sujithkani/ttsky25a-tinyQV/docs/user_peripherals/08_8bit_counter.png

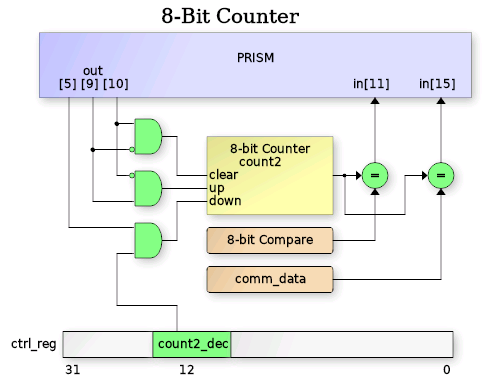
docs/user_peripherals/08_8bit_counter.png
