sujithkani/ttsky25a-tinyQV/docs/user_peripherals/08_comm_register.png

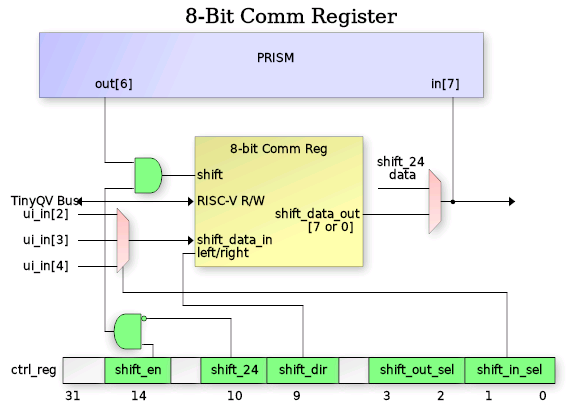
docs/user_peripherals/08_comm_register.png
