sujithkani/ttsky25a-tinyQV/docs/user_peripherals/08_inputs.png

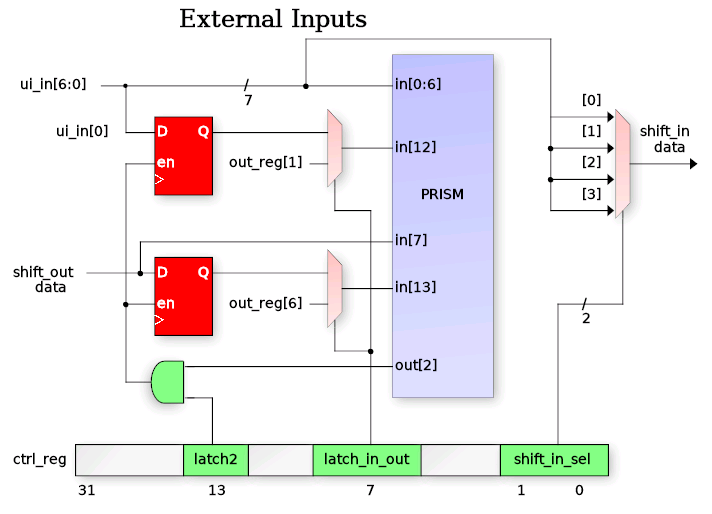
docs/user_peripherals/08_inputs.png
