sujithkani/ttsky25a-tinyQV/docs/user_peripherals/08_outputs.png

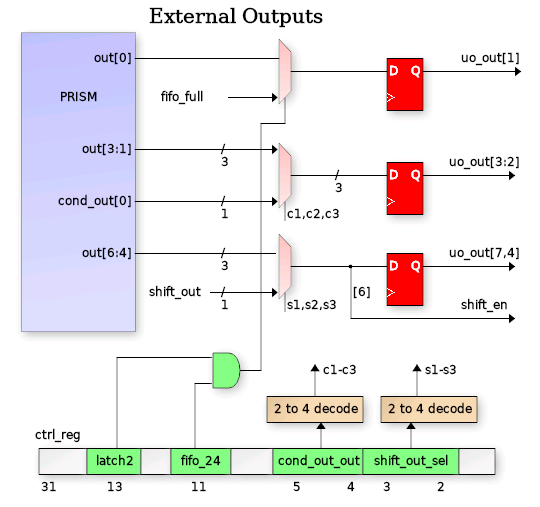
docs/user_peripherals/08_outputs.png
