sujithkani/ttsky25a-tinyQV/docs/user_peripherals/08_prism_periph.png

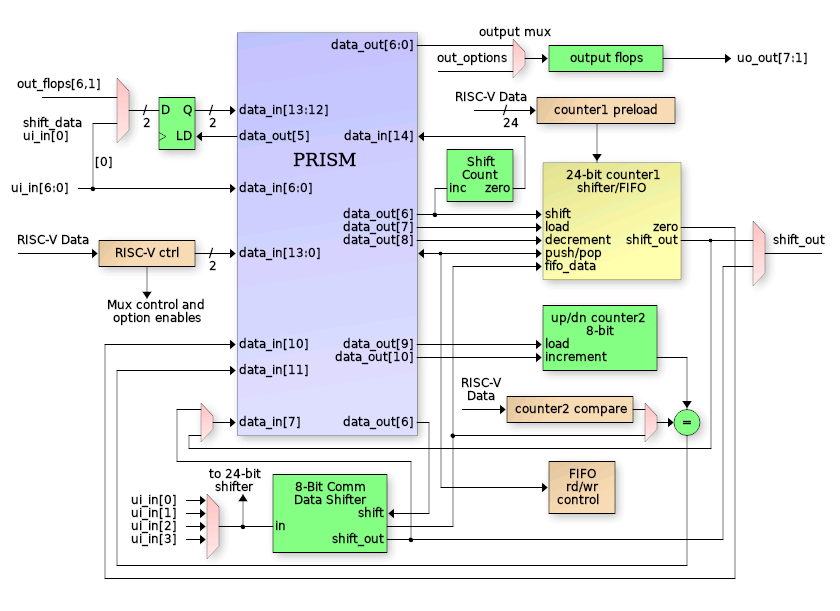
docs/user_peripherals/08_prism_periph.png
