sujithkani/ttsky25a-tinyQV/docs/user_peripherals/10_diagram.png

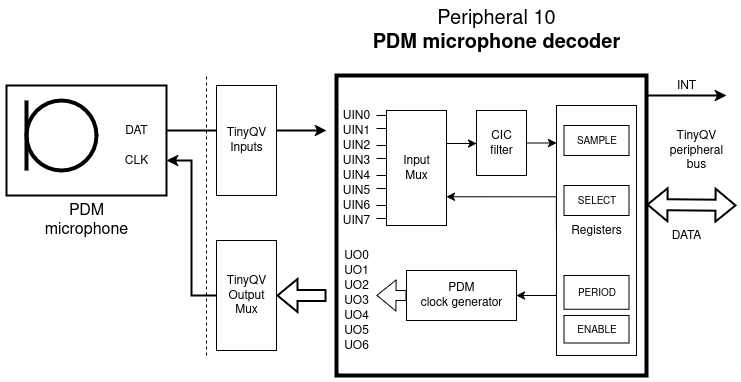
docs/user_peripherals/10_diagram.png
