sujithkani/ttsky25a-tinyQV/docs/user_peripherals/10_spectrogram.png

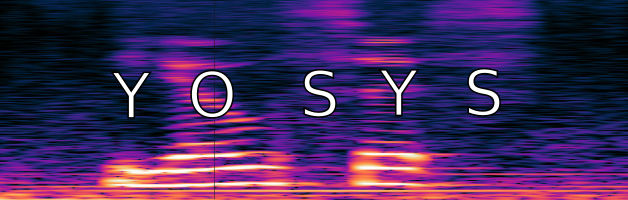
docs/user_peripherals/10_spectrogram.png
