sujithkani/ttsky25a-tinyQV/docs/user_peripherals/11_pulse_transmitter_74HC595.jpg

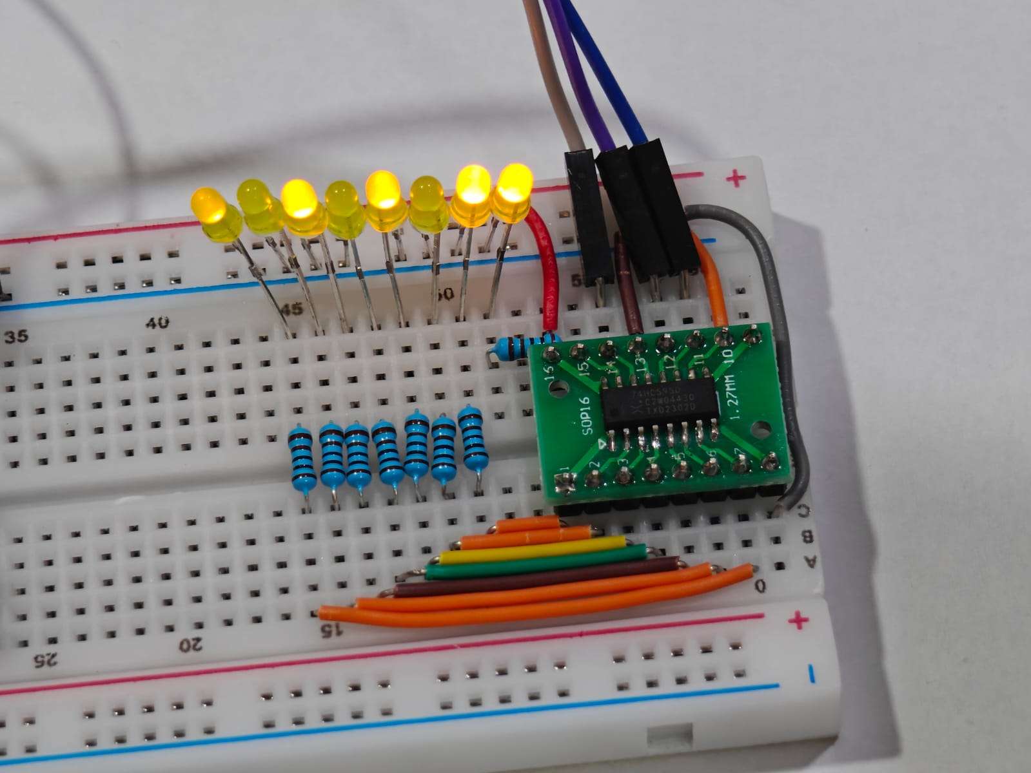
docs/user_peripherals/11_pulse_transmitter_74HC595.jpg
