sujithkani/ttsky25a-tinyQV/docs/user_peripherals/11_pulse_transmitter_I2S.png

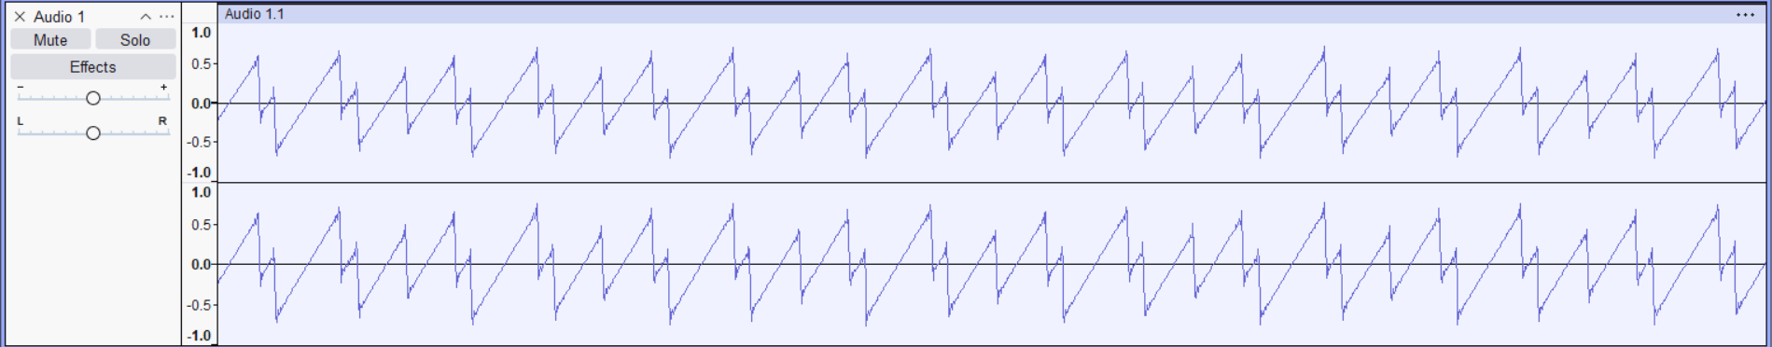
docs/user_peripherals/11_pulse_transmitter_I2S.png
