sujithkani/ttsky25a-tinyQV/docs/user_peripherals/12_cordic_equation.png

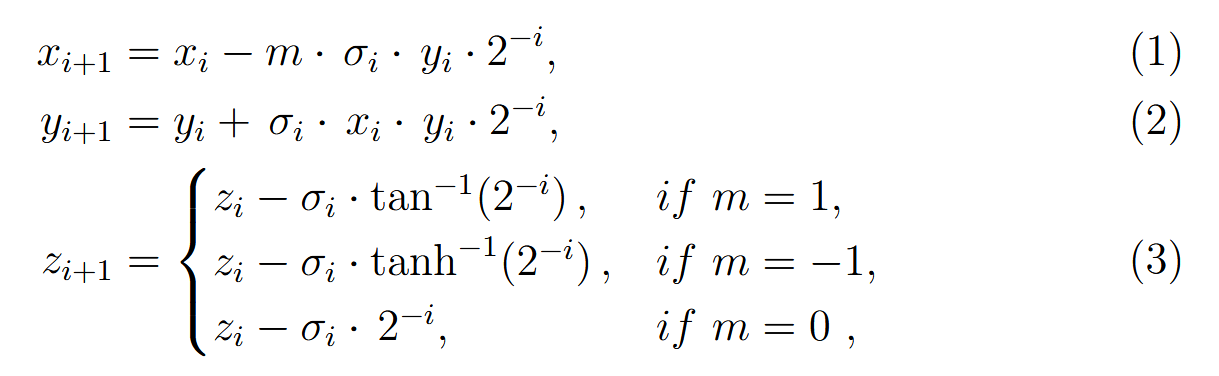
docs/user_peripherals/12_cordic_equation.png
