sujithkani/ttsky25a-tinyQV/docs/user_peripherals/12_cosh.png

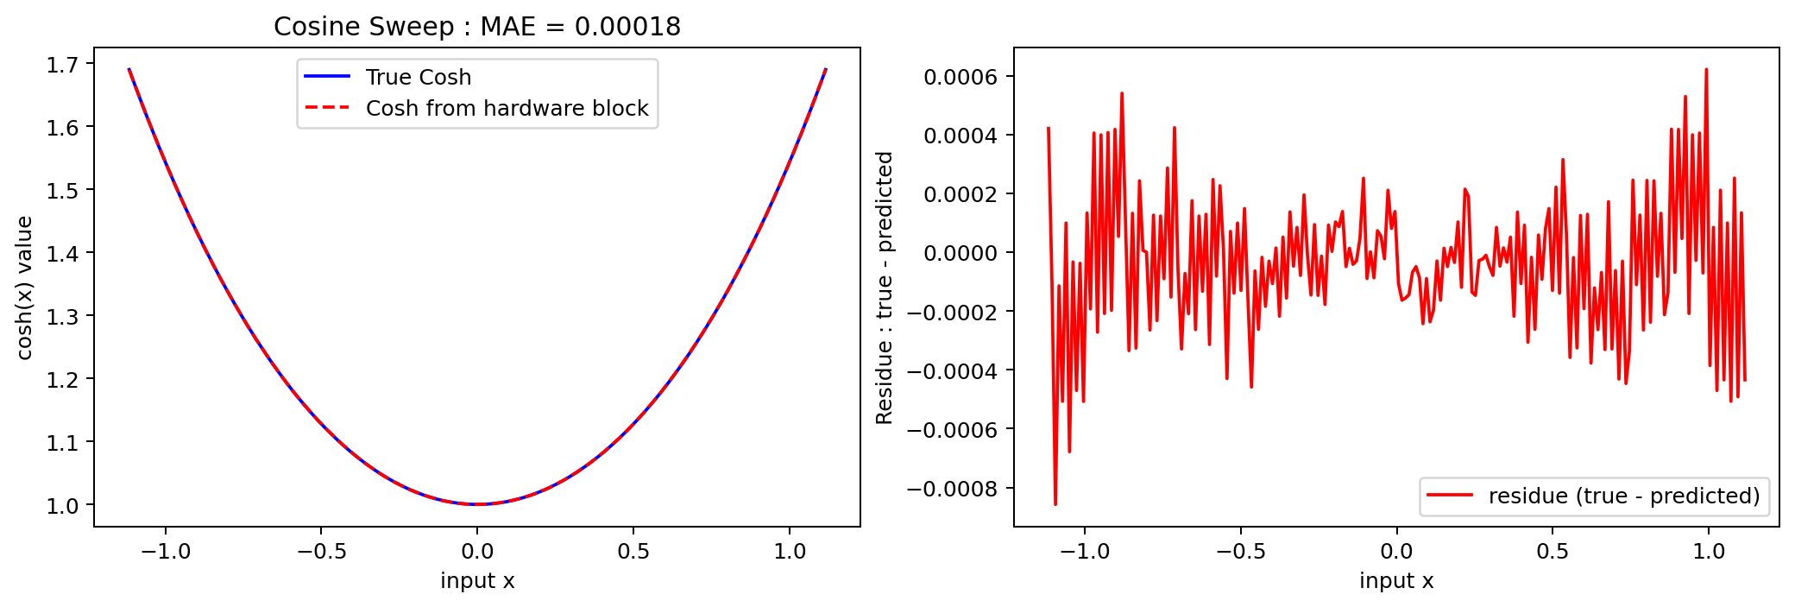
docs/user_peripherals/12_cosh.png
