sujithkani/ttsky25a-tinyQV/docs/user_peripherals/12_cosine.png

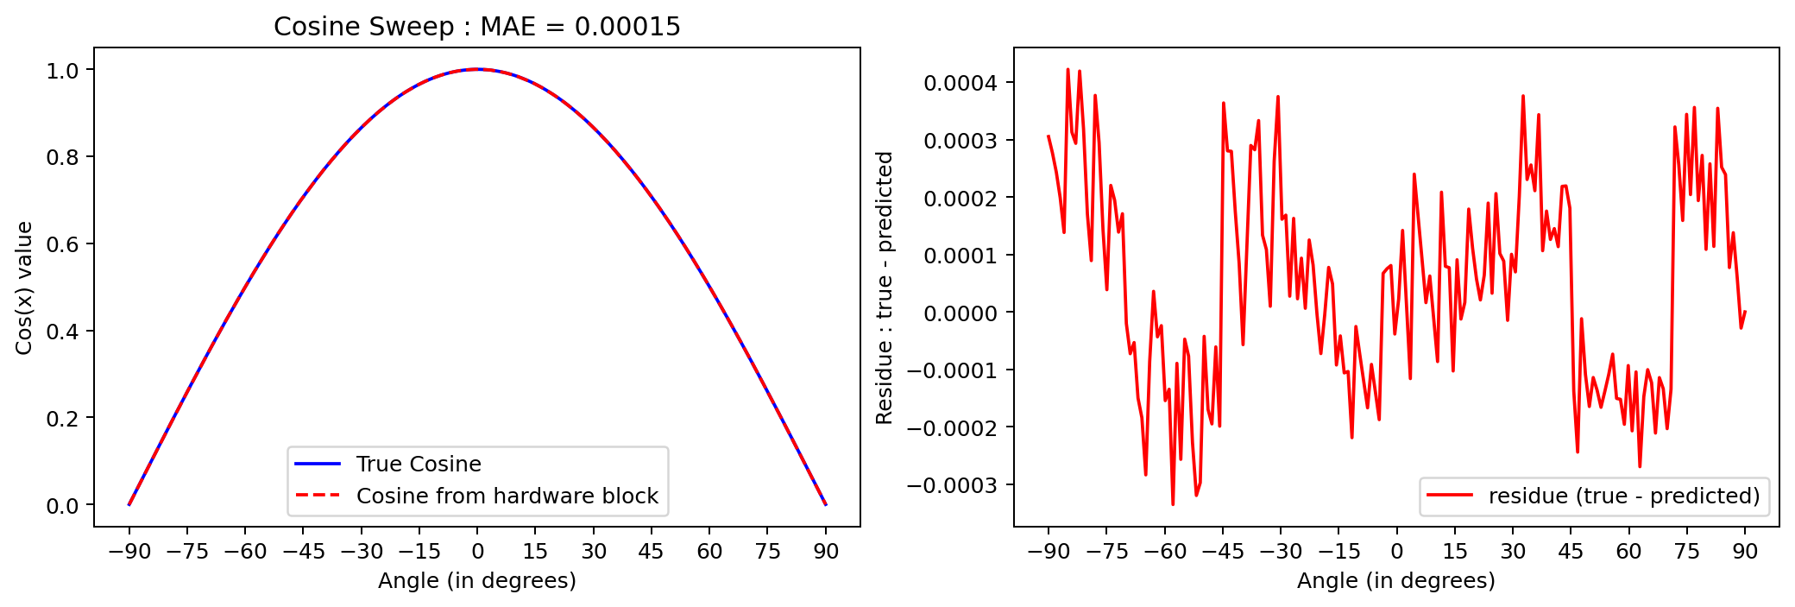
docs/user_peripherals/12_cosine.png
