sujithkani/ttsky25a-tinyQV/docs/user_peripherals/12_sine.png

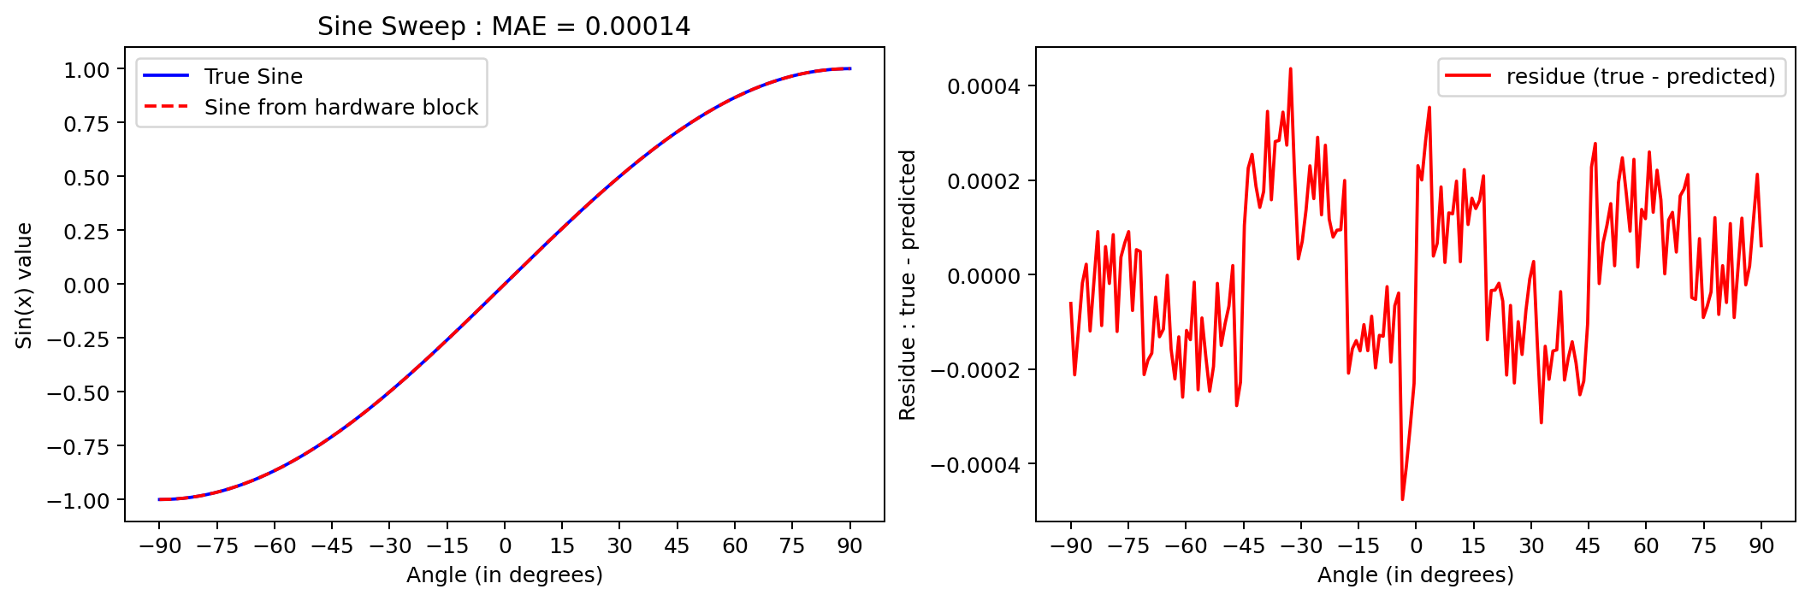
docs/user_peripherals/12_sine.png
