sujithkani/ttsky25a-tinyQV/docs/user_peripherals/12_sinh.png

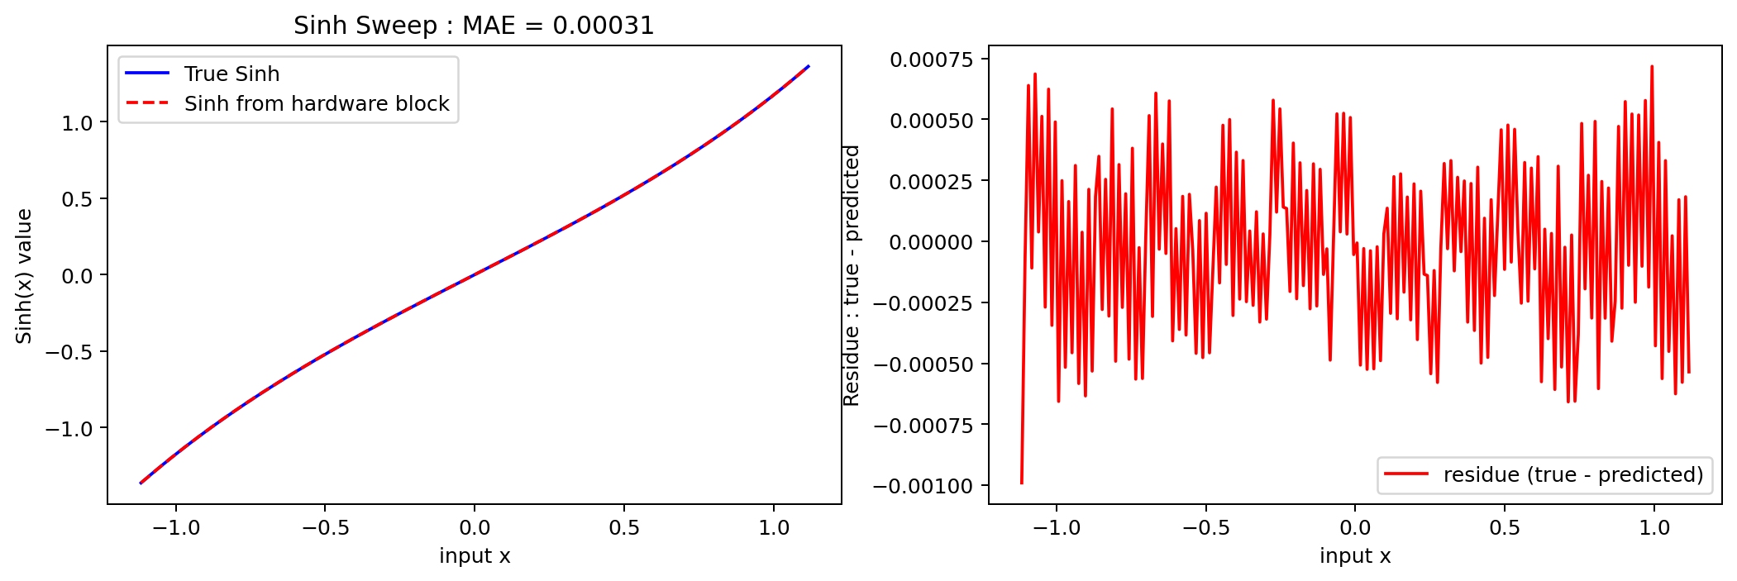
docs/user_peripherals/12_sinh.png
