sujithkani/ttsky25a-tinyQV/docs/user_peripherals/12_sqrt.png

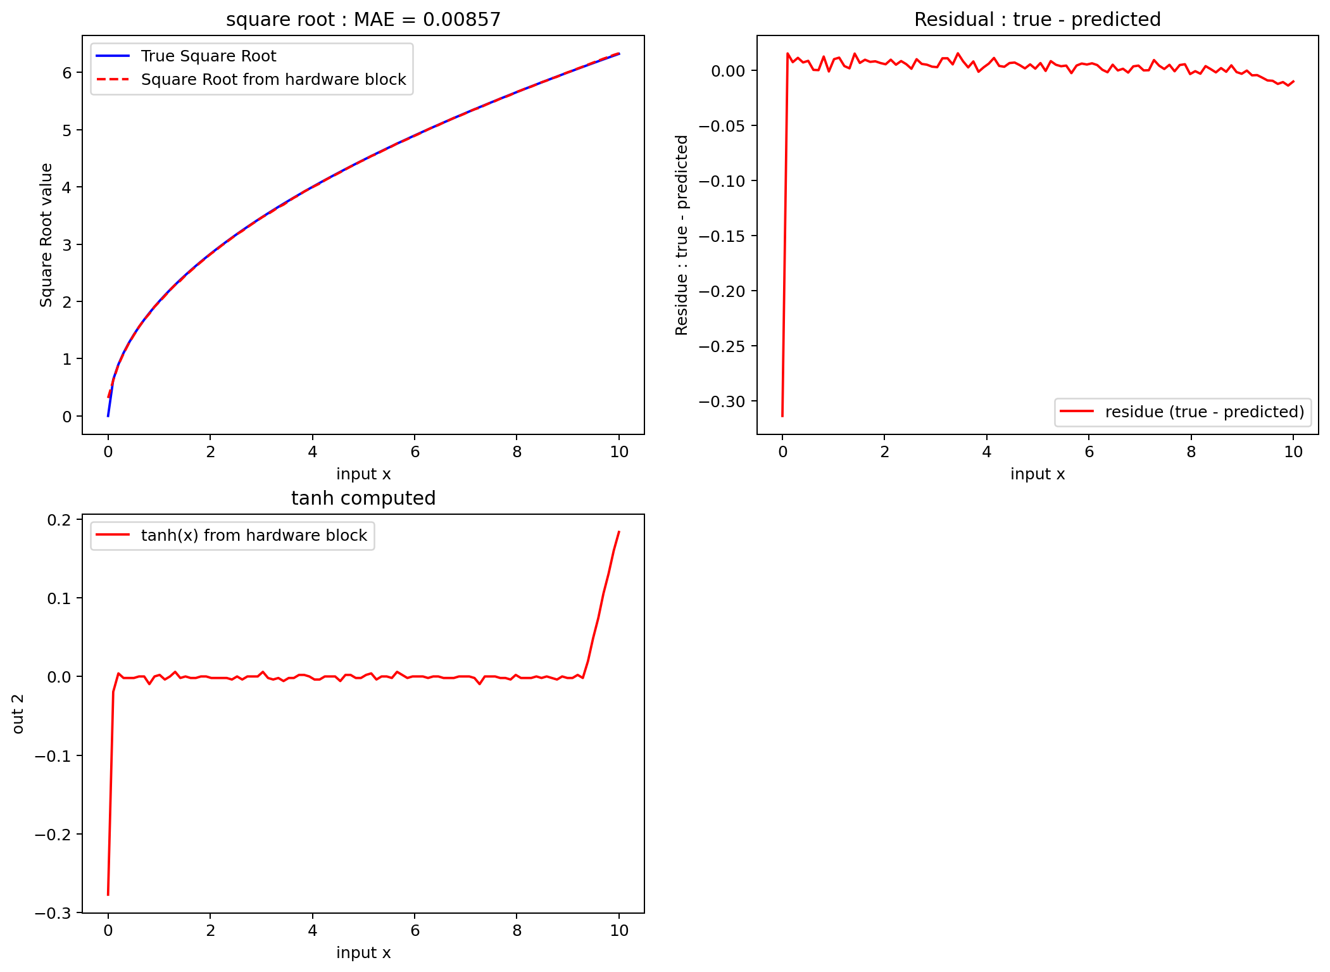
docs/user_peripherals/12_sqrt.png
