sujithkani/ttsky25a-tinyQV/docs/user_peripherals/18_image1.jpg

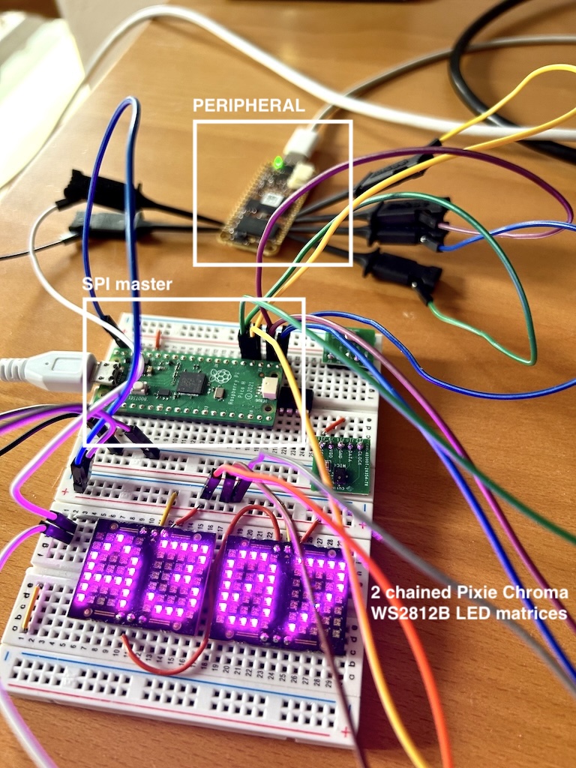
docs/user_peripherals/18_image1.jpg
