sujithkani/ttsky25a-tinyQV/docs/user_peripherals/25_demo1.png

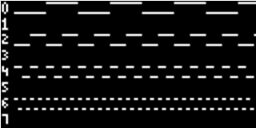
docs/user_peripherals/25_demo1.png
