sujithkani/ttsky25a-tinyQV/docs/user_peripherals/25_demo2.png

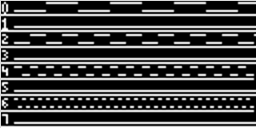
docs/user_peripherals/25_demo2.png
