sujithkani/ttsky25a-tinyQV/docs/user_peripherals/25_demo3.png

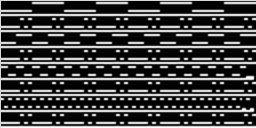
docs/user_peripherals/25_demo3.png
