sujithkani/ttsky25a-tinyQV/docs/user_peripherals/33_pwl_synth_pwl-phase.png

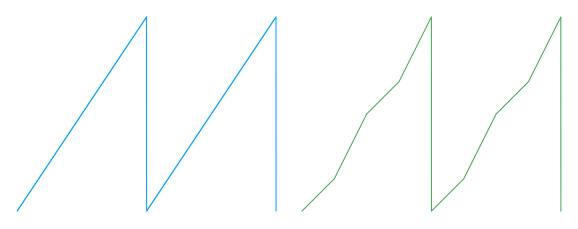
docs/user_peripherals/33_pwl_synth_pwl-phase.png
