sujithkani/ttsky25a-tinyQV/docs/user_peripherals/33_pwl_synth_PWOrionSynth-voice-common_sat.png

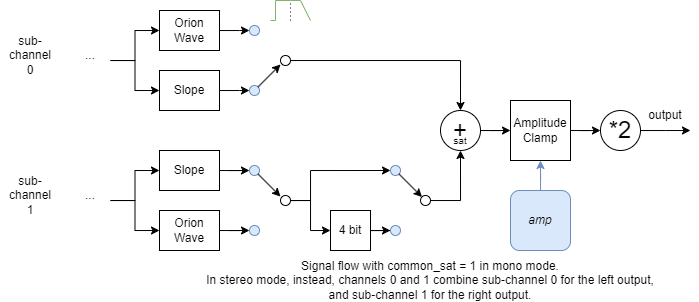
docs/user_peripherals/33_pwl_synth_PWOrionSynth-voice-common_sat.png
