sujithkani/ttsky25a-tinyQV/docs/user_peripherals/33_pwl_synth_PWOrionSynth-voice.png

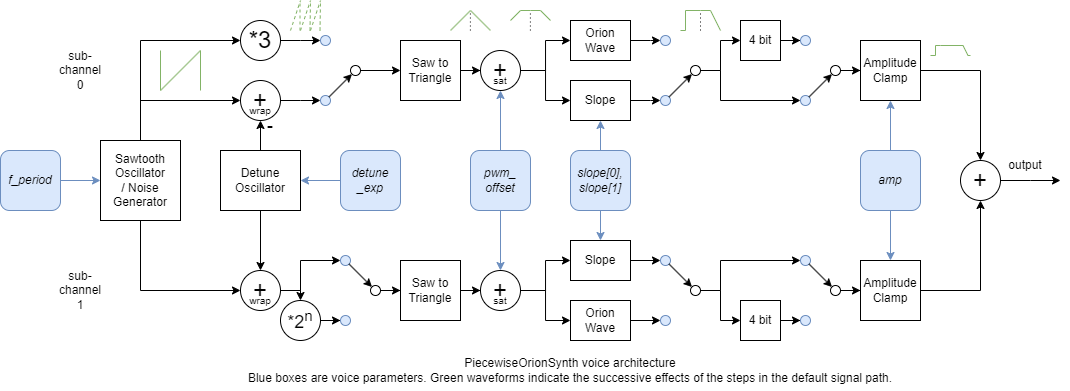
docs/user_peripherals/33_pwl_synth_PWOrionSynth-voice.png
