sujithkani/ttsky25a-tinyQV/docs/user_peripherals/33_pwl_synth_slope.png

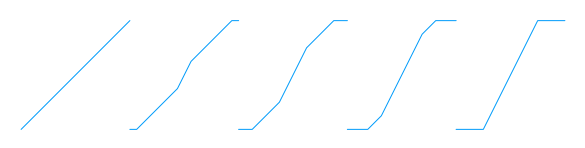
docs/user_peripherals/33_pwl_synth_slope.png
