sujithkani/ttsky25a-tinyQV/docs/user_peripherals/39_reflection.png

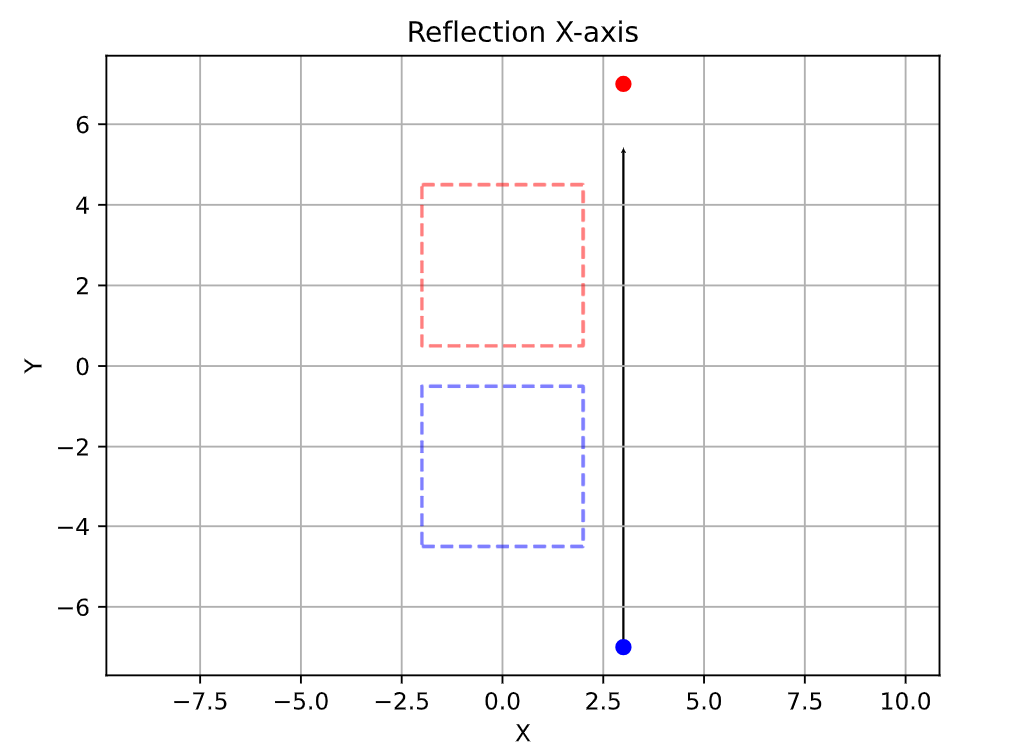
docs/user_peripherals/39_reflection.png
