sujithkani/ttsky25a-tinyQV/docs/user_peripherals/39_rotation.png

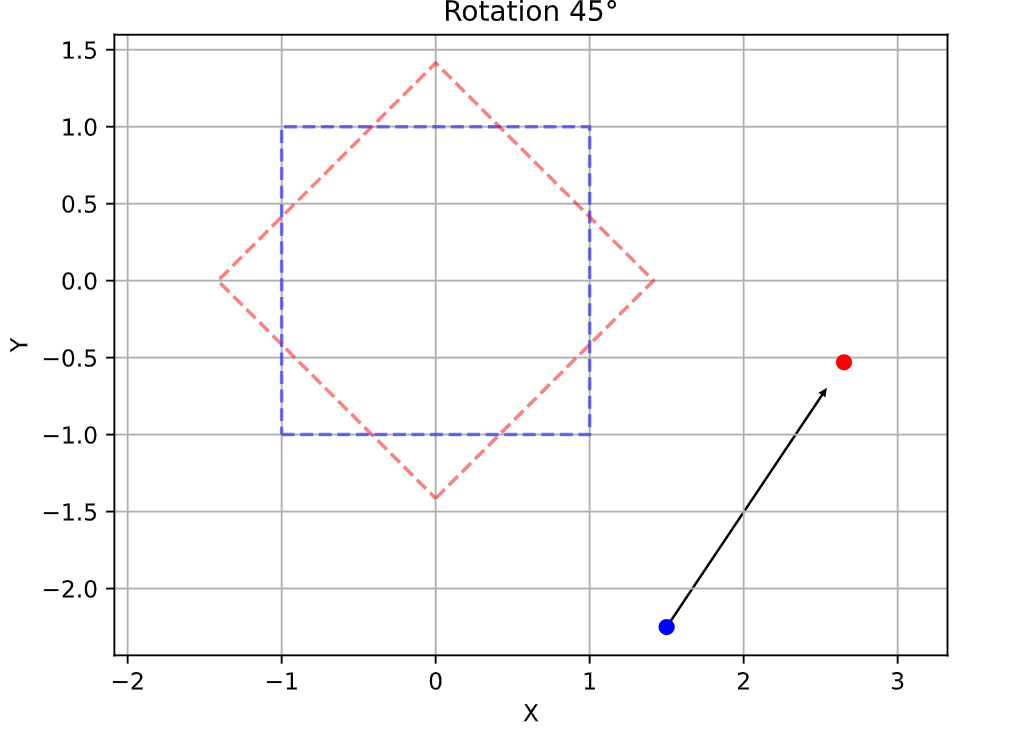
docs/user_peripherals/39_rotation.png
