sujithkani/ttsky25a-tinyQV/docs/user_peripherals/39_scale.png

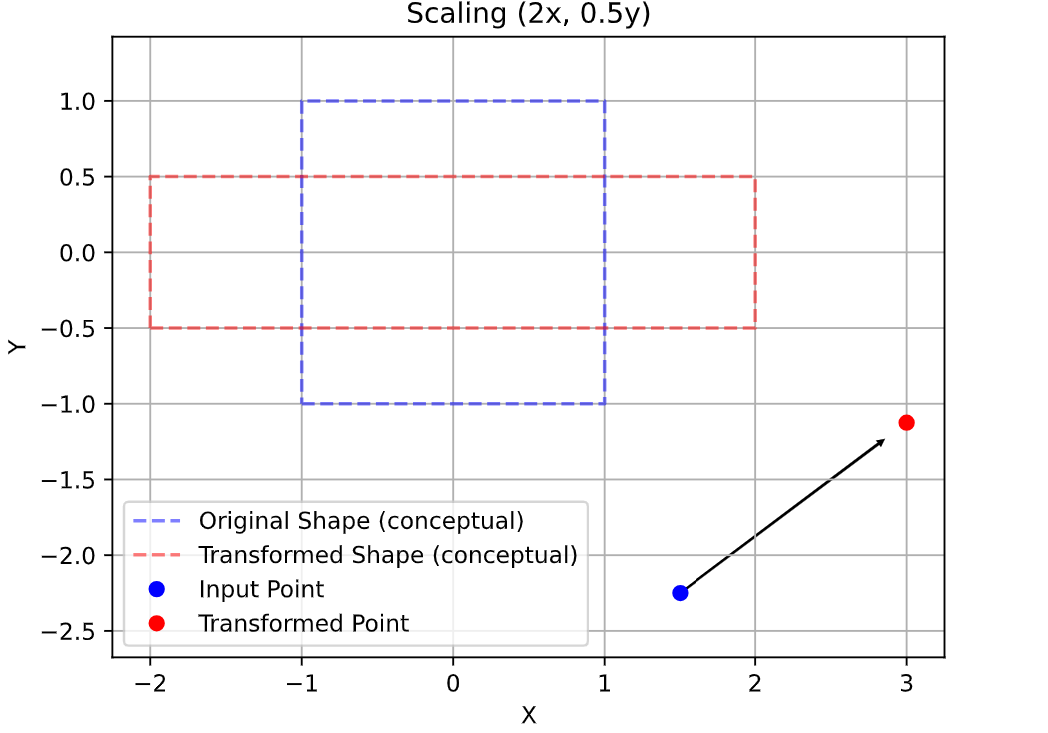
docs/user_peripherals/39_scale.png
