sujithkani/ttsky25a-tinyQV/docs/user_peripherals/39_shear.png

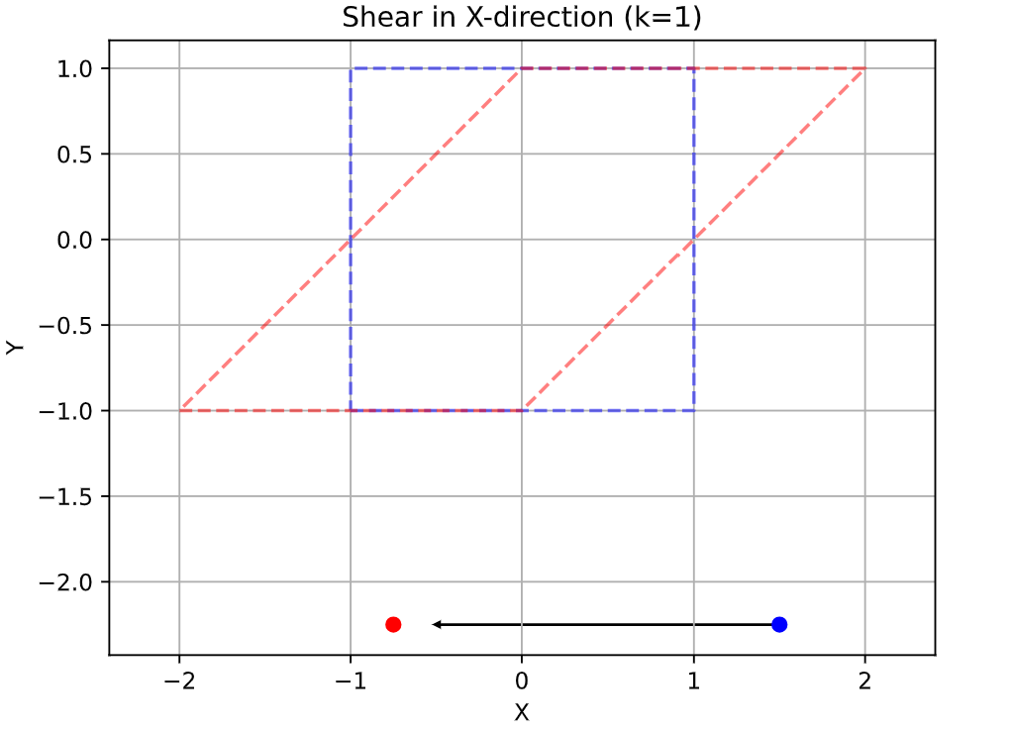
docs/user_peripherals/39_shear.png
