sujithkani/ttsky25a-tinyQV/docs/user_peripherals/vgaconsole_grab.png

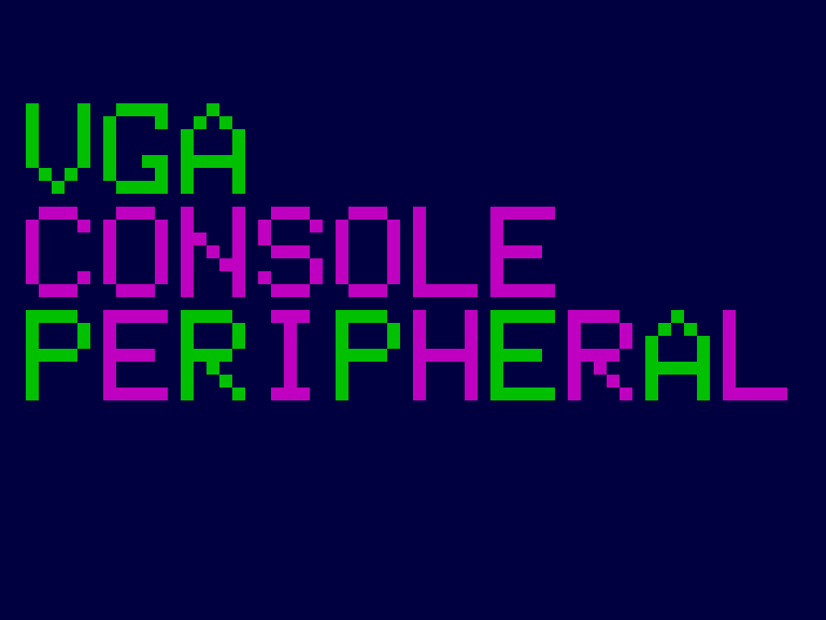
docs/user_peripherals/vgaconsole_grab.png
