sujithkani/ttsky25a-tinyQV/fpga/pico-ice/setup.png

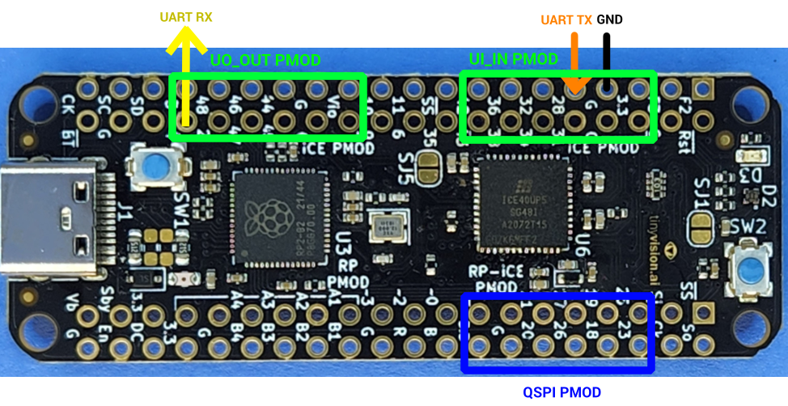
fpga/pico-ice/setup.png
