sujithkani/ttsky25a-tinyQV/test/artifacts/cordic/cosh_vs_true.csv

x | true_cosh | cordic_cosh | residual
-1.116100000000000092e+00 | 1.690239660127017540e+00 | 1.689819335937500000e+00 | -4.203241895175402476e-04
-1.106134821428571557e+00 | 1.676743962250059505e+00 | 1.676513671875000000e+00 | -2.302903750595053367e-04
-1.096169642857143023e+00 | 1.663414774447960154e+00 | 1.663391113281250000e+00 | -2.366116671015383588e-05
-1.086204464285714266e+00 | 1.650250773057650555e+00 | 1.650573730468750000e+00 | 3.229574110994448688e-04
-1.076239285714285732e+00 | 1.637250650819998654e+00 | 1.637756347656250000e+00 | 5.056968362513458715e-04
-1.066274107142857197e+00 | 1.624413116749990671e+00 | 1.623840332031250000e+00 | -5.727847187406709395e-04
-1.056308928571428662e+00 | 1.611736896008529873e+00 | 1.611328125000000000e+00 | -4.087710085298734697e-04
-1.046343750000000128e+00 | 1.599220729775836514e+00 | 1.599243164062500000e+00 | 2.243428666348634692e-05
-1.036378571428571593e+00 | 1.586863375126440934e+00 | 1.587158203125000000e+00 | 2.948279985590662733e-04
-1.026413392857142837e+00 | 1.574663604905754521e+00 | 1.575073242187500000e+00 | 4.096372817454785320e-04
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
