sujithkani/ttsky25a-tinyQV/test/artifacts/cordic/cosine_vs_true.csv

deg | true_cos | cordic_cos | residual
-9.000000000000000000e+01 | 6.123233995736766036e-17 | -3.051757812500000000e-04 | -3.051757812500612574e-04
-8.900000000000000000e+01 | 1.745240643728359839e-02 | 1.727294921875000000e-02 | -1.794572185335983894e-04
-8.800000000000000000e+01 | 3.489949670250108021e-02 | 3.485107421875000000e-02 | -4.842248375108021419e-05
-8.700000000000000000e+01 | 5.233595624294396648e-02 | 5.242919921875000000e-02 | 9.324297580603352342e-05
-8.600000000000000000e+01 | 6.975647374412523305e-02 | 7.000732421875000000e-02 | 2.508504746247669503e-04
-8.500000000000000000e+01 | 8.715574274765813811e-02 | 8.721923828125000000e-02 | 6.349553359186188572e-05
-8.400000000000000000e+01 | 1.045284632676534570e-01 | 1.047973632812500000e-01 | 2.689000135965430305e-04
-8.300000000000000000e+01 | 1.218693434051474900e-01 | 1.222534179687500000e-01 | 3.840745636025100218e-04
-8.200000000000000000e+01 | 1.391731009600654656e-01 | 1.395263671875000000e-01 | 3.532662274345343967e-04
-8.100000000000000000e+01 | 1.564344650402309245e-01 | 1.560058593750000000e-01 | -4.286056652309244708e-04
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
