sujithkani/ttsky25a-tinyQV/test/artifacts/cordic/hyperbolic_invariant.csv

x | cosh2_minus_sinh2_minus_1
-1.116100000000000092e+00 | 1.277923583984375000e-03
-1.106134821428571557e+00 | 7.666796445846557617e-04
-1.096169642857143023e+00 | 5.212724208831787109e-04
-1.086204464285714266e+00 | 9.362101554870605469e-04
-1.076239285714285732e+00 | 5.193948745727539062e-04
-1.066274107142857197e+00 | 1.007616519927978516e-04
-1.056308928571428662e+00 | -7.968097925186157227e-04
-1.046343750000000128e+00 | 5.670338869094848633e-04
-1.036378571428571593e+00 | 5.083531141281127930e-04
-1.026413392857142837e+00 | -3.600120544433593750e-05
-1.016448214285714302e+00 | 1.244205981492996216e-03
-1.006483035714285768e+00 | 3.800392150878906250e-04
-9.965178571428572329e-01 | -9.393692016601562500e-05
-9.865526785714286984e-01 | 1.868754625320434570e-04
-9.765875000000000528e-01 | 1.050602644681930542e-03
-9.666223214285715182e-01 | -8.052960038185119629e-05
-9.566571428571428726e-01 | 9.143725037574768066e-05
-9.466919642857143380e-01 | -4.981122910976409912e-04
-9.367267857142858034e-01 | -5.683302879333496094e-05
-9.267616071428572688e-01 | 3.164410591125488281e-04
-9.167964285714286232e-01 | 7.244944572448730469e-05
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
