sujithkani/ttsky25a-tinyQV/test/artifacts/cordic/sine_vs_true.csv

deg | true_sin | cordic_sin | residual
-9.000000000000000000e+01 | -1.000000000000000000e+00 | -9.999389648437500000e-01 | 6.103515625000000000e-05
-8.900000000000000000e+01 | -9.998476951563912696e-01 | -9.996337890625000000e-01 | 2.139060938912695775e-04
-8.800000000000000000e+01 | -9.993908270190957621e-01 | -9.992675781250000000e-01 | 1.232488940957621182e-04
-8.700000000000000000e+01 | -9.986295347545738332e-01 | -9.985961914062500000e-01 | 3.334334832383323288e-05
-8.600000000000000000e+01 | -9.975640502598241977e-01 | -9.975585937500000000e-01 | 5.456509824197652847e-06
-8.500000000000000000e+01 | -9.961946980917455452e-01 | -9.960327148437500000e-01 | 1.619832479955451987e-04
-8.400000000000000000e+01 | -9.945218953682732899e-01 | -9.944458007812500000e-01 | 7.609458702328986135e-05
-8.300000000000000000e+01 | -9.925461516413219831e-01 | -9.925537109375000000e-01 | -7.559296178016872148e-06
-8.200000000000000000e+01 | -9.902680687415703620e-01 | -9.900512695312500000e-01 | 2.167992103203619791e-04
-8.100000000000000000e+01 | -9.876883405951377704e-01 | -9.877319335937500000e-01 | -4.359299861222964978e-05
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
