sujithkani/ttsky25a-tinyQV/test/artifacts/cordic/sinh_vs_true.csv

x | true_sinh | cordic_sinh | residual
-1.116100000000000092e+00 | -1.362684889718197123e+00 | -1.361694335937500000e+00 | 9.905537806971231873e-04
-1.106134821428571557e+00 | -1.345908732025329124e+00 | -1.345336914062500000e+00 | 5.718179628291242267e-04
-1.096169642857143023e+00 | -1.329266230614378541e+00 | -1.329040527343750000e+00 | 2.257032706285411194e-04
-1.086204464285714266e+00 | -1.312755732791661689e+00 | -1.312805175781250000e+00 | -4.944298958831083723e-05
-1.076239285714285732e+00 | -1.296375598972191678e+00 | -1.296813964843750000e+00 | -4.383658715583216292e-04
-1.066274107142857197e+00 | -1.280124202516856879e+00 | -1.279357910156250000e+00 | 7.662923606068794413e-04
-1.056308928571428662e+00 | -1.263999929570888137e+00 | -1.263793945312500000e+00 | 2.059842583881366096e-04
-1.046343750000000128e+00 | -1.248001178903593189e+00 | -1.247802734375000000e+00 | 1.984445285931890623e-04
-1.036378571428571593e+00 | -1.232126361749345866e+00 | -1.232299804687500000e+00 | -1.734429381541335857e-04
-1.026413392857142837e+00 | -1.216373901649812073e+00 | -1.216918945312500000e+00 | -5.450436626879273661e-04
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
