sujithkani/ttsky25a-tinyQV/test/artifacts/cordic/sqrt_vs_true.csv

s | 2sqrt_s | true_norm | err
5.000000000000000000e-01 | 1.414213562373095145e+00 | 1.412676143498840853e+00 | -1.537418874254292689e-03
5.798319327731091821e-01 | 1.522933922103134607e+00 | 1.521751722191364120e+00 | -1.182199911770487333e-03
6.596638655462184753e-01 | 1.624393875322384329e+00 | 1.623752128211939816e+00 | -6.417471104445127139e-04
7.394957983193277684e-01 | 1.719878830987029428e+00 | 1.718087763837905735e+00 | -1.791067149123692914e-03
8.193277310924369505e-01 | 1.810334478589453289e+00 | 1.808296215405235774e+00 | -2.038263184217514734e-03
8.991596638655461327e-01 | 1.896480597175247862e+00 | 1.896146276081916549e+00 | -3.343210933313134348e-04
9.789915966386554258e-01 | 1.978880083924900557e+00 | 1.977510761809312401e+00 | -1.369322115588156308e-03
1.058823529411764719e+00 | 2.057983021710106275e+00 | 2.055337661200734356e+00 | -2.645360509371919022e-03
1.138655462184873901e+00 | 2.134156003843087124e+00 | 2.131985365146831679e+00 | -2.170638696255444700e-03
1.218487394957983083e+00 | 2.207702330440390881e+00 | 2.206864275924942387e+00 | -8.380545154484941861e-04
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
