sujithkani/ttsky25a-tinyQV/test/artifacts/cordic/cosh.png

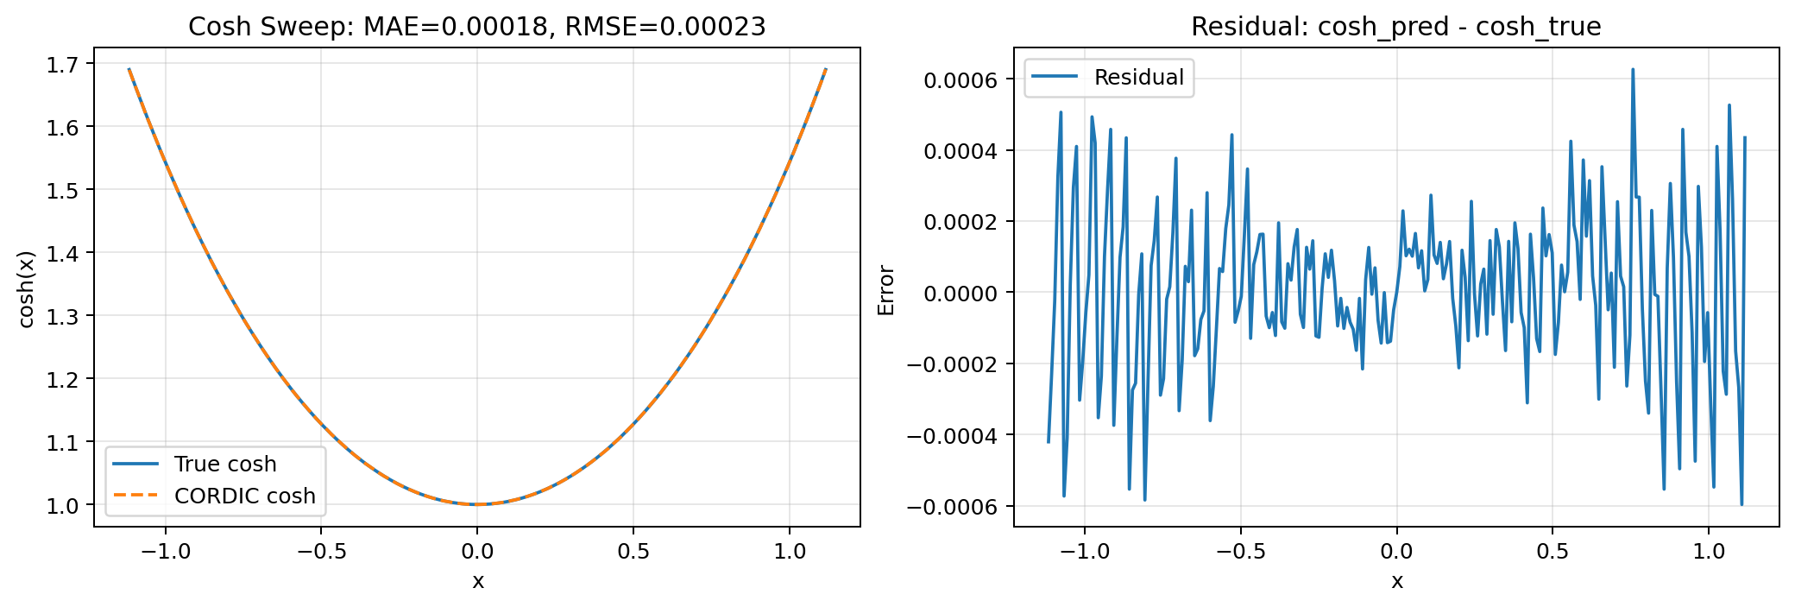
test/artifacts/cordic/cosh.png
