sujithkani/ttsky25a-tinyQV/test/artifacts/cordic/cosine.png

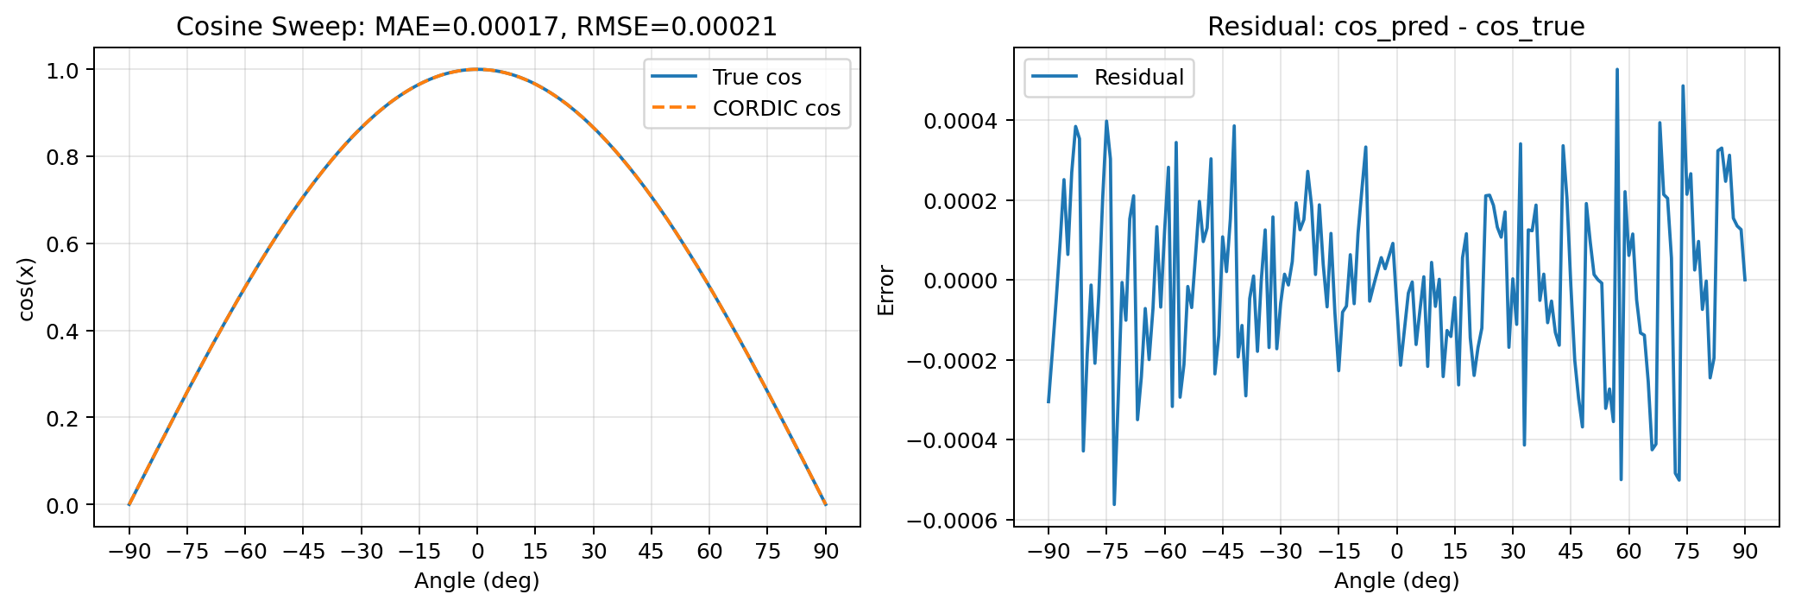
test/artifacts/cordic/cosine.png
