sujithkani/ttsky25a-tinyQV/test/artifacts/cordic/hyperbolic_invariant.png

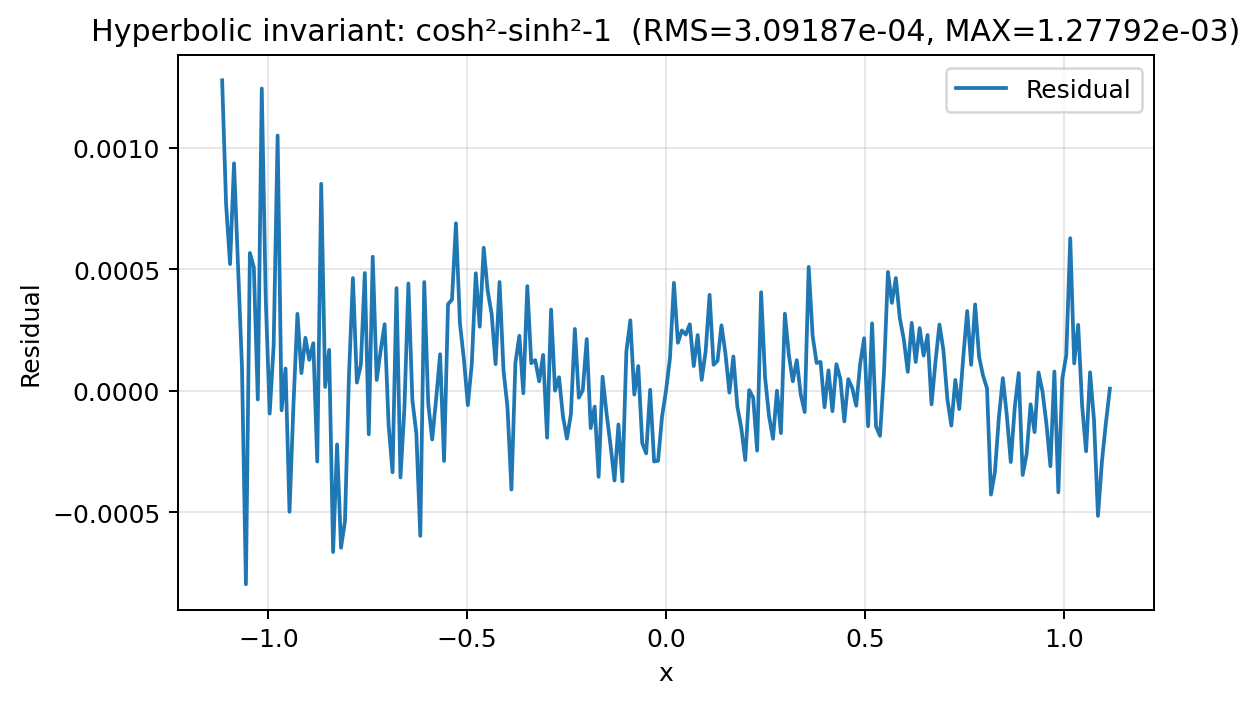
test/artifacts/cordic/hyperbolic_invariant.png
