sujithkani/ttsky25a-tinyQV/test/artifacts/cordic/ln.png

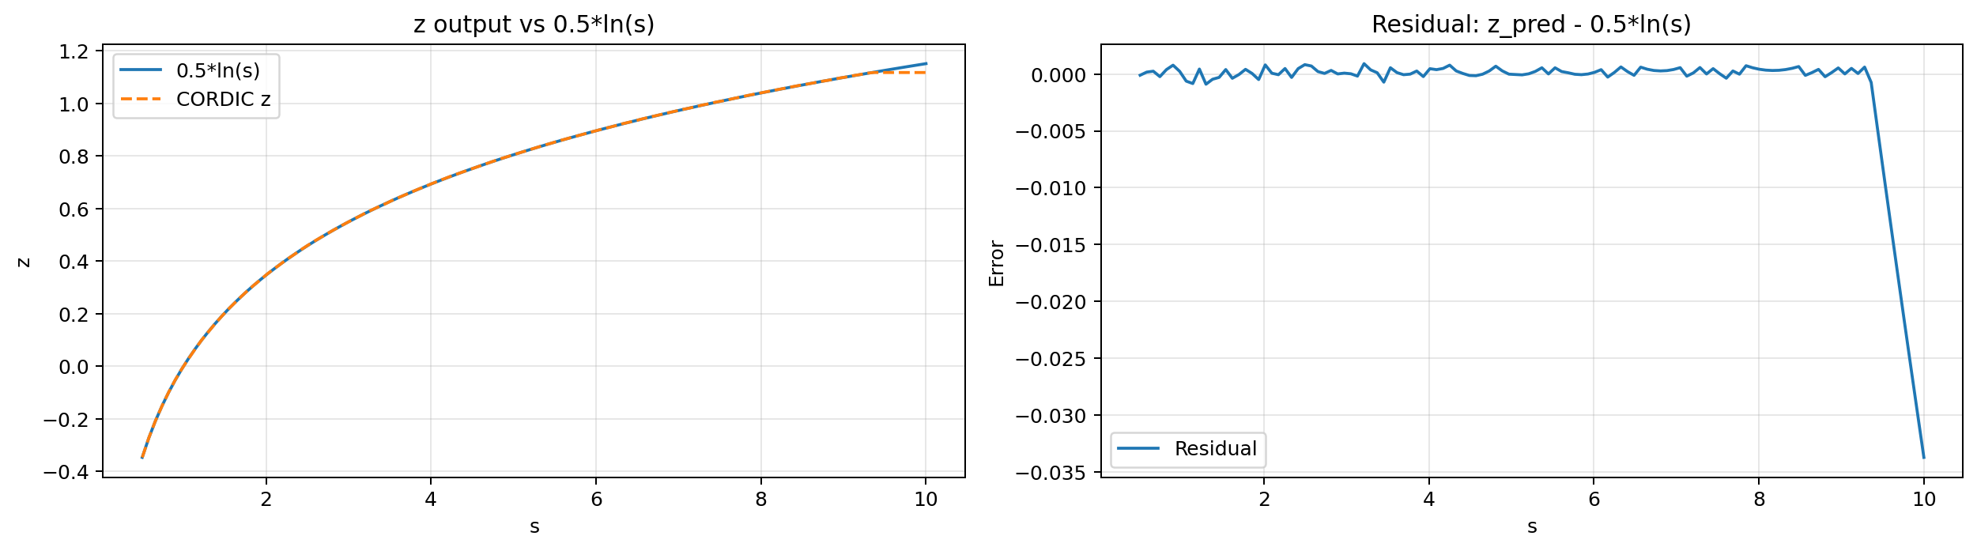
test/artifacts/cordic/ln.png
