sujithkani/ttsky25a-tinyQV/test/artifacts/cordic/sine.png

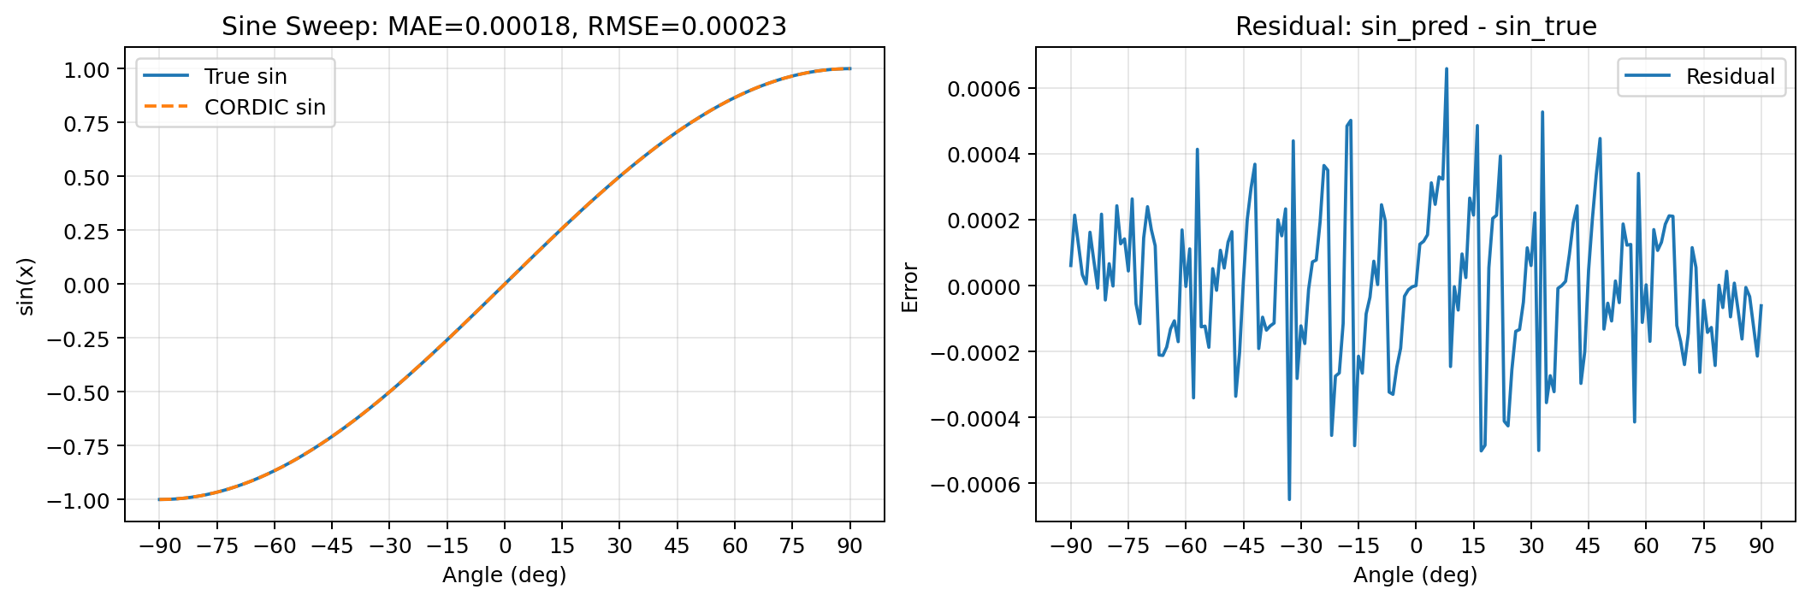
test/artifacts/cordic/sine.png
