sujithkani/ttsky25a-tinyQV/test/artifacts/cordic/sinh.png

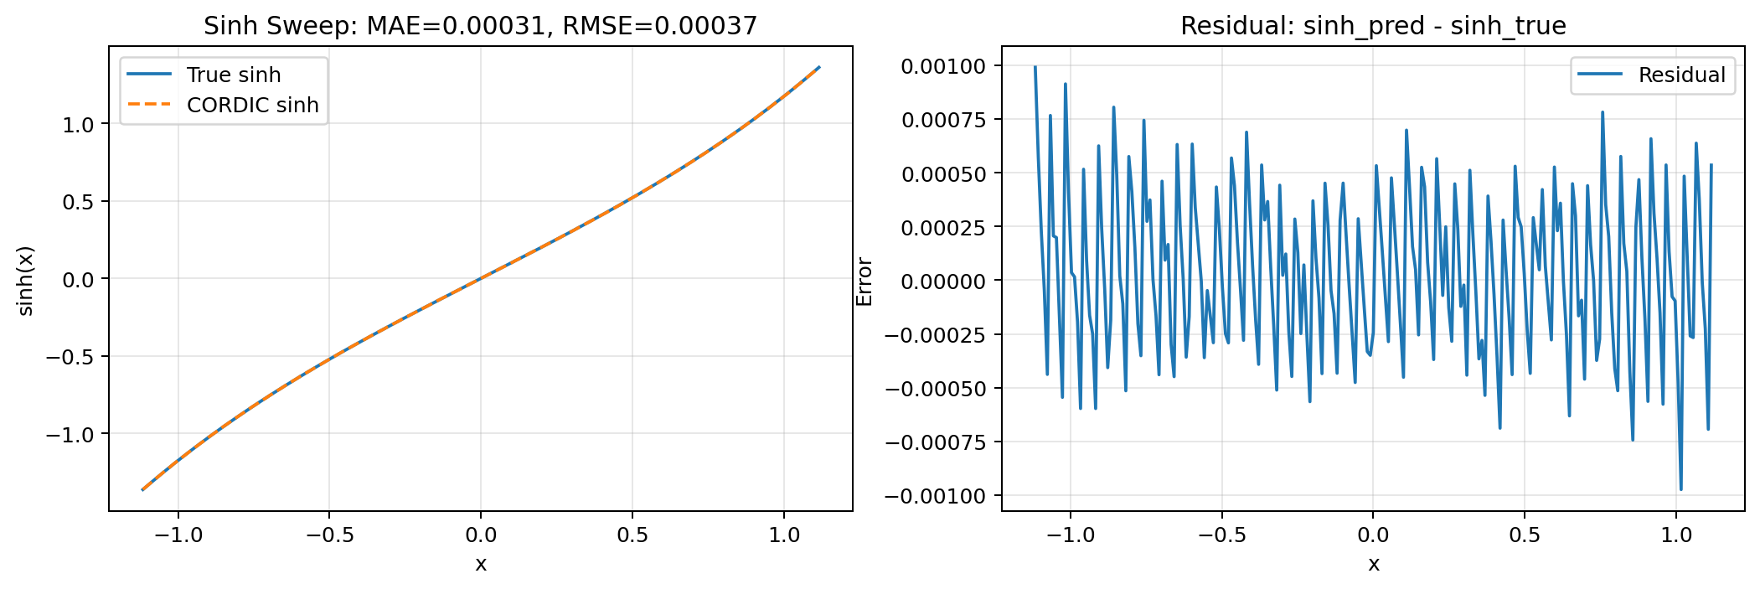
test/artifacts/cordic/sinh.png
