sujithkani/ttsky25a-tinyQV/test/artifacts/cordic/sqrt.png

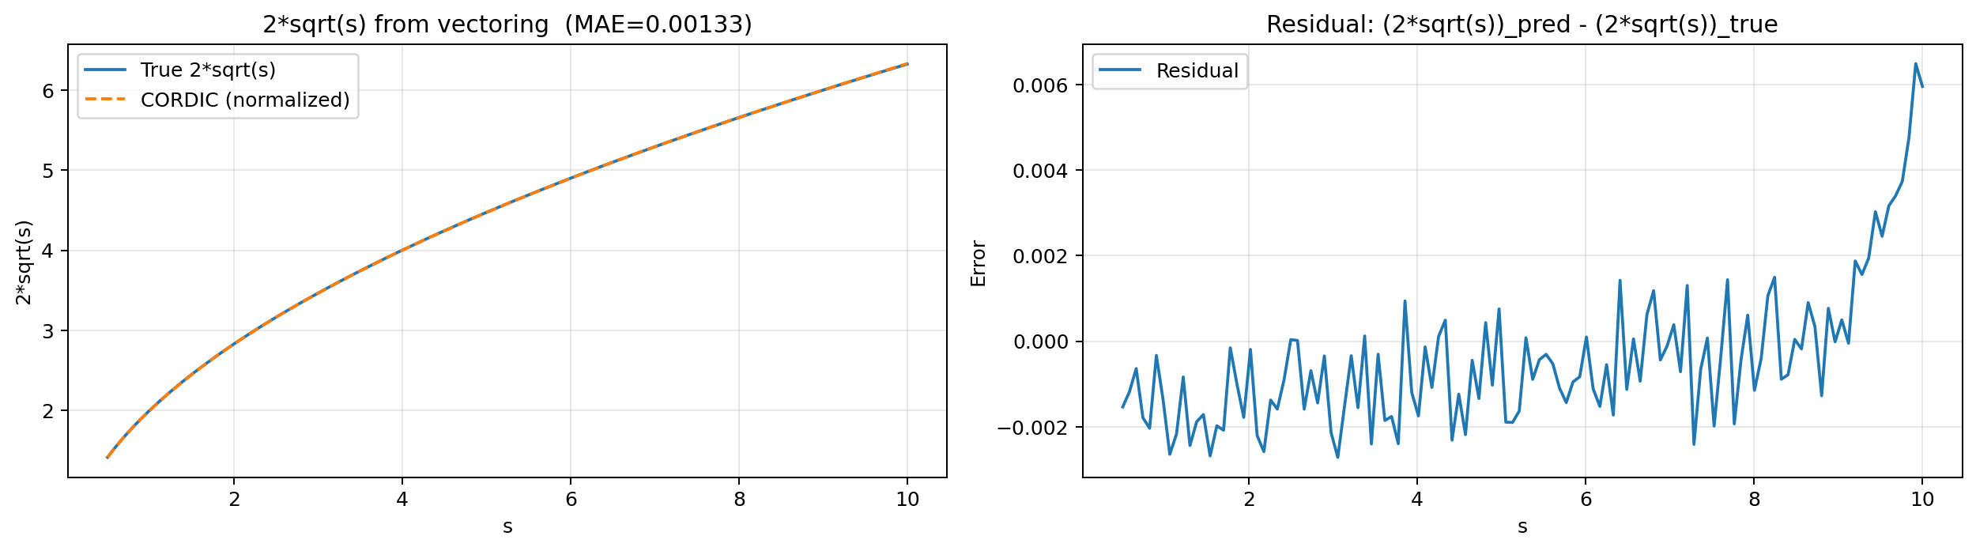
test/artifacts/cordic/sqrt.png
