sujithkani/ttsky25a-tinyQV/test/artifacts/cordic/unit_circle_residual.png

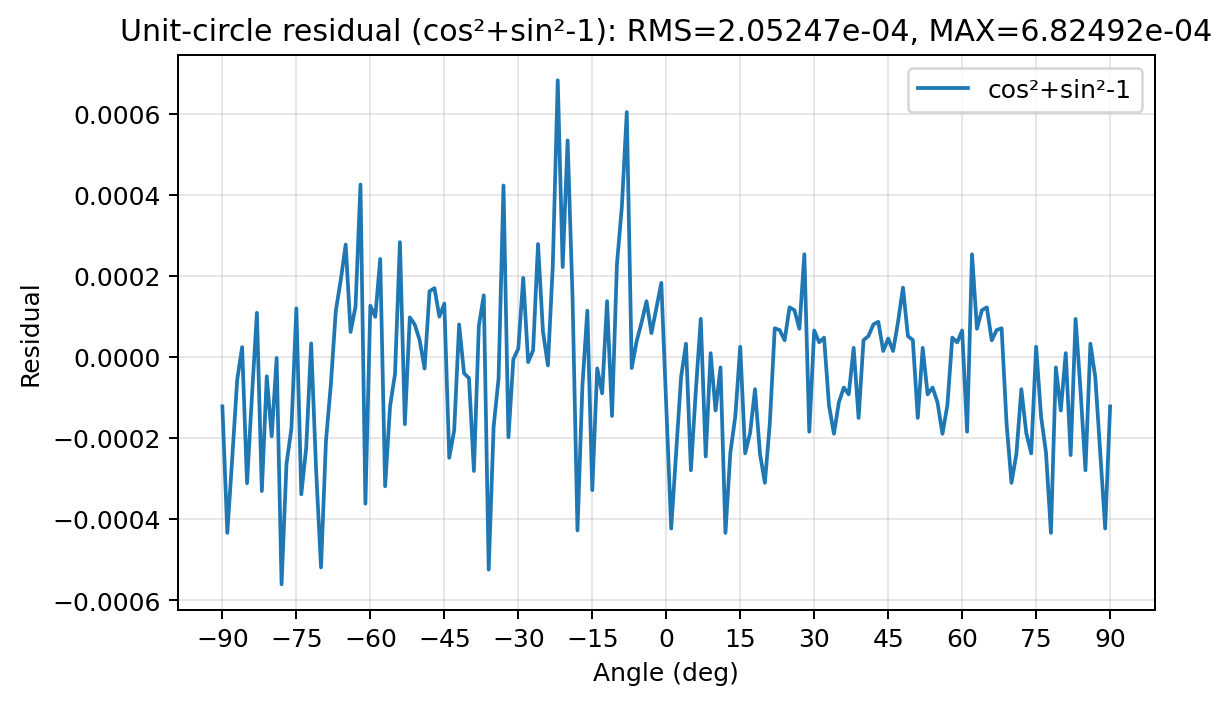
test/artifacts/cordic/unit_circle_residual.png
