sujithkani/ttsky25a-tinyQV/test/vga_ref2.png

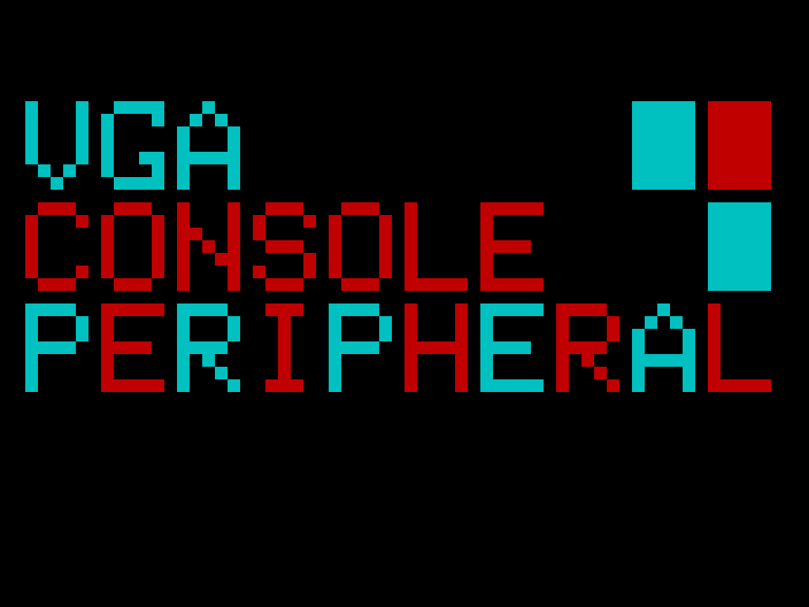
test/vga_ref2.png
