sujithkani/ttsky25a-tinyQV/(commit log)

2025-01-08 Use read_complete with UART peripheral.
    Thanks to @ahmedcharles
2025-01-08 Add PWM, remove latency 4-5.
2025-01-15 Prepare submission with latches and modified CTS
    [metrics.csv]
2025-01-15 Fix SPI test
2025-01-16 Update artifacts
    [metrics.csv]
2025-01-16 Fix reset of latched config
    [metrics.csv]
2025-01-23 Add timer interrupts
    [metrics.csv]
2025-02-09 Add game controller, and many tweaks
    [metrics.csv]
2025-02-09 Update debug enable pins
    [metrics.csv]
2025-02-11 Add internal RAM
    [metrics.csv]
2025-02-11 Update tinyQV
    [metrics.csv]
2025-02-12 Finer control of QSPI clock delay
    [metrics.csv]
2025-02-25 Switch back to normal TT flow
    [metrics.csv]
2025-02-25 Fix tests, move where input sync is
    [peripherals.v]
2025-07-01 Updates from CAD25a prototype
2025-07-15 Add configurable divider to UART
2025-07-16 Fix interrupt during multi word transaction
2025-07-17 Fix additional read cycles
    [peripherals.v]
2025-07-17 Buffer one byte in UART RX
2025-07-22 Add 4x quadrature encoder to TinyQV
2025-07-23 add encoder source
2025-07-24 Ability to check interrupt in test
2025-07-24 Fix different behaviour of uart_rx pin in peripheral tests
2025-07-25 fix source include and wait for bouncing switches to stop before reading the register
2025-07-25 Make all peripheral slots explicit
2025-07-26 Update impostor_WS2812b.v
    RebelMike — 1:57
    Sorry, missed this message somehow - looks like the problem is undriven bits in uo_out, you should set all unused outputs to 0.
2025-07-26 added WS2812B LED strip byte peripheral
2025-07-26 Create __init__.py
    chatgpt says i have import module probems , but i dont know why Matt did not
2025-07-26 UART improvements
2025-07-28 add Matt PWM
2025-08-02 Improved timer implementation
2025-08-04 Fix write dword reg with bits 31:12 all set
    To write a dword to a memory mapped register, the testbench wrapper was constructing an lui + addi pair, but was not masking the immediate value for lui. In the case where bits 31:12 were all set in the value being written, the calculation of the immediate value for lui would be outside of the representable range, which would cause InstructionLUI to throw an exception.
    This change fixes the issue by masking the calculated immediate value into the representable range. The calculation itself was already correct, so does not need any further modification. For example if value = 0xFFFFFFFF, then (value + 0x800) >> 12 = 0x100000. Masking this value int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
2025-08-04 Add WatchDog Timer peripheral
2025-08-05 Switch to use slot 7 to avoid conflicts
    [peripherals.v]
2025-08-05 Switch to use slot 8 to avoid conflicts
    [peripherals.v]
2025-08-06 Switch to slot 9 to avoid conflicts
    [peripherals.v]
2025-08-07 Stage changes
2025-08-07 Add start, stop action bit for program. Add interrupt tests
2025-08-07 Clamp the value
2025-08-07 Test framework fixes
2025-08-07 Fix the fix to the test framework.
2025-08-08 Fix interrupt tests
2025-08-08 Pico-ICE FPGA build
2025-08-10 Update to latest version of DWARF line table accelerator
    Additional testing caught a bug where the accelerator was incorrectly
    parsing the argument of DW_LNE_set_address as u64, whereas the operand
    should in fact be the architecture address length, which in the case of
    RV32E is u32. This change fixes the hardware and the associated test.
2025-08-10 Tweak timer
2025-08-12 Hardware UTF Encoder/Decoder - https://github.com/RebeccaRGB/tinyqv-hardware-utf8
2025-08-13 ledstrip peripheral: remove warning in character ROM
2025-08-13 Fix according to PR
    [peripherals.v]
2025-08-14 Cut down test
2025-08-14 Updated prism test case to fix run errors.
2025-08-14 Correction on peripheral instance, crc32 is on ID 25
    [peripherals.v]
2025-08-15 Universal Segmented LED Driver
2025-08-15 Update Baby VGA with vblank interrupt + misc fixes
2025-08-17 Fix corner case in ALU
2025-08-17 Add SPI controller
2025-08-17 Remove old SPI test
2025-08-19 ledstrip peripheral: reduce gate count
2025-08-21 Additional full peripheral slots with no interrupt
2025-08-25 all test pass
    [cosh_vs_true.csv, cosine_vs_true.csv, hyperbolic_invariant.csv, sine_vs_true.csv, sinh_vs_true.csv, sqrt_vs_true.csv, unit_circle_residual.csv, z_vs_half_ln_s.csv]
2025-08-28 cleaned up VGA frame grab
2025-08-29 Update Baby VGA to fix video mode & interrupts
2025-08-29 trigger interrupt at line 768 instead of 0
2025-08-30 add: hamming(7,4) error correction encoder/decoder by enmanuel
    [peripherals.v]
2025-08-31 feat: add TinyTone PWM peripheral to slot 15
    - Add mkTinyTone_Peripheral.v with MMIO interface
    - Memory-mapped registers for frequency control
    - PWM output on pin 0 for audio generation
2025-08-31 fix: correct port mapping for mkTinyTone_Peripheral
    - Fix port names to match BSV-generated interface
    - CLK/RST_N instead of clk/rst_n
    - write_data_address instead of address
    - Proper enable signals for BSV methods
    [peripherals.v]
2025-08-31 fix: remove extra closing parenthesis in peripherals.v
    [peripherals.v]
2025-08-31 Drive all uo_out pins with PWM output
2025-08-31 Antenna and timing tweaks
2025-08-31 Fix multi-store interrupt interaction
2025-09-04 Switch RV2A03 and vga gfx
2025-09-05 pdm: clear interrupt on any size read of sample
2025-09-06 Move CORDIC to 12 to allow interrupt
2025-09-07 Fix PWL synth left connection
    [peripherals.v]
